jiaola1234-tech/adau1979-fpga/对比分析与处理建议.md

# FPGA 底板与 DSP 大板对比及改造建议

## 依据

- FPGA/底板工程：`2026底板开发板-7.7/后改2025底板电路原理图.SchDoc`、`后改2025底板线路板图.PcbDoc`
- DSP 工程：`DSP大板子/DSP大板子.SchDoc`、`DSP大板子/DSP大板子.PcbDoc`
- 两个目录中未发现 `.v/.sv/.vhd/.xdc/.qsf/.xpr/.sof/.bit` 等 FPGA HDL、管脚约束或比特流文件，以下是硬件级对比。

## 对比表

| 功能块 | 原 FPGA 底板 | DSP 大板 | 结论 / FPGA 侧处理 |
|---|---|---|---|
| ADC 主器件 | U6：1 颗 AD7606 | U3、U10：2 颗 ADAU1979WBCPZ-RL | 不能按引脚替换；从并行 SAR ADC 改成音频串行 ADC，需重做原理图、PCB、RTL 接收链和初始化软件。 |
| 模拟输入通道 | `ADIN1~ADIN8`，8 路 | `AIN1_P/N~AIN8_P/N`，8 路差分；同时保留 `ADIN1~ADIN8` 作为前级接口 | 保留前级 ADIN 命名可以减少改线，但每路要重新核对差分、共模、电平、增益和抗混叠滤波。不能把 AD7606 的模拟输入网络直接接到 ADAU1979。 |
| AD7606 数字接口 | `DB0~DB15`、`CS`、`CONVSTAB`、`BUSY`、`RESET`、`RD` | 无并行数据总线；`MCLK`、`BCLK`、`LRCLK`、`SDATAOUT01/02/11/12`、`SCL/SDA`、`ADC_PD_RST_N` | 删除/隔离 AD7606 的 DB/CS/CONVST/BUSY/RD 逻辑；新增 I2C 主控、音频串行接收器、帧同步和复位时序。 |
| 音频时钟 | Y7：25 MHz；主要是 FPGA/PS 时钟 | OSC1：24.576 MHz；另外有 X1：12 MHz、Y1：25 MHz | 24.576 MHz 是音频时钟，不能由 25 MHz 直接代替。建议在 ADAU1979 附近保留独立低抖动时钟，并在 FPGA 中建立独立 audio clock domain。 |
| ADAU 控制 | 无 ADAU 控制总线 | `SCL/SDA`，两颗 ADAU 共用音频时钟，`ADC_PD_RST_N` 为复位/掉电控制 | 需要确认两颗 ADAU 的 I2C 地址/地址脚；上电后按数据手册写寄存器，再打开数据流。 |
| ADAU 数据通道 | 不存在 | 两颗 ADAU 输出 `SDATAOUT01/02/11/12`，共享 `BCLK/LRCLK/MCLK` | 先确认 DSP 工程配置的是 2-wire/4-wire、左对齐/I2S/TDM、采样率和每帧槽位，再实现 FPGA RX；不要只按信号名连接。 |
| 前级仪表放大 | 8 颗 AD620BR | 同样有 8 颗 AD620BR | 这部分可作为复用基础，但要按 ADAU1979 的满量程和输入共模重新计算 AD620 增益。 |
| 后级模拟处理 | 未发现 LT1793、DG201 | 8 颗 LT1793（U27~U34）+ 8 颗 DG201（U35~U42），另有 `GAIN_X1/X10/X30/X99` | 这是 DSP 相对 FPGA 的主要模拟硬件增量。若功能要求与 DSP 一致，应增加抗混叠/缓冲/增益切换链；`CS0~CS7` 多半是 DG201 控制，不能误当 ADAU 的片选。 |
| 参考/偏置 | FPGA 工程有 `REFIN`、`AVCC`、`VDRIVE` 等 AD7606 相关电源/参考网络 | DSP 有 `VBIAS_1V5`、`VBIAS_1V5_RAW`、U43 REF2030、U44 OPA192、`IOVDD`、`AVDD` | 删除 AD7606 的参考/驱动网络；新增 1.5 V 模拟偏置、3.0 V 参考/缓冲和 ADAU 的 AVDD/IOVDD 去耦，按数据手册分区供电。 |
| FPGA/处理器连接 | 大量 `FPGA_*`、`PS_*`、`IOxx`，含 RGMII `PS_ETH_*` | DSP 侧有 `UP_*`、`VPIF_*`、多路 UART 和扩展连接 | ADAU 数据接入 FPGA 后，需明确由 FPGA 直接处理，还是送到外部 DSP。若 FPGA 直接处理，DSP 侧 VPIF/控制器不必照搬；若保留 DSP，则只需把音频链路接到 DSP 接口。 |
| 以太网 | U100：RTL8211E-VB；`PS_ETH_TXD0~3/RXD0~3`，RGMII 风格 | U12：KSZ8081RNACA-TR；`RMII_*`、`ETH_TXP/M`、`ETH_RXP/M`，含 RJ45/ESD | 不能直接替换。两者 MAC 接口宽度、时钟和 PHY 配置不同；建议保留 FPGA 原 RGMII，以太网部分只移植 DSP 的接口防护/磁性器件需求。 |
| CAN | TJA1057 收发器，FPGA 侧有 `CAN_RX/CAN_TX` | MCP2515（U9）+ TJA1057，`CAN_CS_N/CAN_SCK/CAN_SI/CAN_SO/CAN_INT_N/CAN_RST_N` | DSP 的 MCP2515 是完整 SPI CAN 控制器。若 FPGA 已有 CAN 控制器，不要重复加入 MCP2515；只有在需要复用 DSP 软件/协议且 FPGA 无 CAN 控制器时才增加 SPI 外设。 |
| EEPROM | 未发现 M24C64 | U5：M24C64，I2C | 若需要保存 ADAU 配置、校准系数或板卡参数，新增 EEPROM，并与 ADAU I2C 地址/上拉电阻统一规划。 |
| USB/串口 | U20：CH340C | U1：CH340G | 功能近似；保留 FPGA 原 USB-UART 即可，核对 5 V/3.3 V 电平和 USB ESD。 |
| 电源体系 | 有 24 V、+12 V、±15 V、+5、1.8 V、3.3 V、AD7606 `AVCC/VDRIVE` 等 | 有 `+24V_SYS`、`+5V_SYS`、±12 V、±15 V、`VBIAS_1V5`、`AVDD`、`IOVDD`；TPS54560、URA2412、URA2415、REF2030/OPA192 等 | 先做电源树和电流预算，再决定哪些 DSP 电源级移植。ADAU 的模拟/数字电源、时钟和基准必须单独核对噪声与上电时序。 |
| 扩展连接器 | 2×30、2×20、2×5 等 FPGA/底板连接 | 4 个 `CON50A_0`，另有 2×5、2×7 等 DSP 扩展 | 连接器、针脚数和机械位置不兼容。建议先定义一份“FPGA-ADAU/DSP 信号分配表”，再改 PCB，不要边画板边分配信号。 |
| PCB/布线 | 原板有 AD7606 并行总线、FPGA 高速 IO、RGMII | DSP 板有两颗 ADAU、模拟前端、音频时钟、RMII、CAN、较多模拟电源 | 建议以 FPGA 板为主板重新布局 ADC/时钟/模拟区；不能只替换封装或做局部 ECO。 |

## 推荐处理顺序

1. **先冻结系统架构**：确认 ADAU1979 的两颗器件由 FPGA 直接接收，还是仍由外部 DSP 接收；确认采样率（48/96/192 kHz）、输出格式（I2S/TDM/左对齐）、位宽、通道槽位和是否需要 8 路同时处理。
2. **建立信号分配表**：至少包含 `AINx_P/N`、`MCLK/BCLK/LRCLK`、4 路 `SDATAOUT`、`SCL/SDA`、`ADC_PD_RST_N`、8 路 `GAIN_X* / CS0~CS7`、电源和地。每个信号同时写明 FPGA 管脚、连接器针脚、电平标准、方向和时钟域。
3. **重画模拟链**：以 DSP 板的 AD620 → LT1793 → DG201 → ADAU1979 为参考，把 8 路复制到 FPGA 版本；重新计算 AD620 增益、LT1793 滤波器、DG201 导通电阻/电压范围、ADAU 满量程和 1.5 V 共模。输入端、模拟地和数字地按 ADC 数据手册布局。
4. **重做电源和时钟**：加入 24.576 MHz 音频振荡器、ADAU AVDD/IOVDD、1.5 V 偏置/参考和去耦；为模拟电源、数字电源、时钟电源做电流预算、噪声预算和上电顺序检查。
5. **先实现最小 FPGA RTL**：`i2c_master` → ADAU 初始化寄存器表 → `audio_rx`（MCLK/BCLK/LRCLK/SDATA）→ 8 通道 FIFO/AXI-Stream → 原 DSP 算法接口。先不接 Ethernet/CAN 等附加功能，先验证音频采集链。
6. **再处理外设增量**：按需求选择 EEPROM、MCP2515、KSZ8081/RJ45、USB-UART 和 DSP 连接器。已有 FPGA RGMII/CAN 控制器的功能不要重复移植，只移植真正缺失的硬件。
7. **最后改 PCB**：完成封装库、层叠、阻抗、模拟/数字分区、时钟和音频差分/单端走线后，再进行 DRC、3D、装配和可制造性检查。AD7606 的原并行总线区域不能直接当作 ADAU 布局区域使用。

## FPGA 侧最小 RTL/软件模块

- `adau1979_i2c_init`：两颗器件独立地址、复位延时、寄存器配置、读回校验。
- `audio_clk/reset`：24.576 MHz 时钟输入、BCLK/LRCLK 同步、跨时钟域 FIFO、复位释放顺序。
- `adau1979_rx`：根据实际格式接收 24-bit 样本，做符号扩展、通道重排和帧错误检测。
- `gain_switch_ctrl`：如果保留 DG201，生成 `CS0~CS7` 或对应 `GAIN_X1/X10/X30/X99` 控制，并设置 break-before-make。
- `calibration/eeprom`：可选，用于保存通道增益、偏置和 ADAU 配置。

## 上板前必须验证的项目

- ADAU 两颗 I2C 地址是否冲突；SCL/SDA 上拉电压是否与 FPGA I/O 电平一致。
- 24.576 MHz、BCLK、LRCLK 的频率关系和抖动；FPGA 约束是否覆盖所有 generated clocks。
- 8 路输入的满量程、共模、电源范围、AD620 增益和 LT1793 截止频率。
- `SDATAOUT01/02/11/12` 的通道顺序、帧槽位、MSB/LSB 顺序和 24-bit 对齐。
- ADAU AVDD/IOVDD、1.5 V 偏置和数字电源的上电、掉电、复位时序。
- FPGA 管脚复用是否与原 `PS_ETH_*`、LCD、DDR、JTAG、UART、CAN 等功能冲突。
- 音频链路先用示波器/逻辑分析仪确认时钟和 I2C，再用已知正弦输入验证 8 路幅值、相位、噪声和失真。

## 目前无法从目录直接确定的内容

- FPGA 型号、封装和实际管脚号；
- 现有 AD7606 的 HDL 采集时序和软件寄存器接口；
- ADAU1979 两颗器件的 I2C 地址脚配置；
- 最终采样率/串行音频格式/通道槽位；
- FPGA 板与 DSP 板连接器的针脚一一对应关系。

这些内容需要 FPGA 源工程、ADAU1979 原理图页或数据手册配置表补齐后，才能生成可直接用于约束文件和 PCB 的最终引脚表。

## 隔离、保护和电源器件专项对比

| 类别 | 原 FPGA 底板 | DSP 大板 | 建议 |
|---|---|---|---|
| 信号隔离 | U21：ISO7221AD 数字隔离器；FPGA 板没有 PC817 类光耦 | U2：PC817X2CSP9F 双路光耦；Q1：2N7002 做后级整形/电平转换 | ISO7221AD 不是光耦，不能与 PC817 按器件名称等同。只有移植 DSP 的 24 V 脉冲/外部控制接口时，才新增 PC817 隔离链。 |
| 电源隔离 | U241：URA2424S-6WR3；U242：URA2415S-6WR3 | U25：URA2412S-6WR3；U26：URA2415YMD-15WR3 | 需要按 ADAU、模拟前端和外部接口的实际电压/电流重新核算，不能直接照抄型号。重点确认隔离侧地、耐压、输出纹波和启动时序。 |
| 输入浪涌/电源保护 | F1：24 V 保险丝；D2：SMAJ13CA；D241：BZT52C24；另有 6 个 PESD3V3L1BA | F1：0451003；D1/D8：SMBJ33A；D7：BZT52C12；Q2：DMP6023LE-13；另有 PESD3V3L1BA | FPGA 已有基本保护，但 DSP 的 24 V 输入保护链更完整。迁移时按实际外部电压选择 TVS 的反向工作电压和钳位电流，不要只按封装替换。 |
| CAN 保护 | FPGA 有 TJA1057，但未看到 DSP 的 PESD2CAN | DSP 有 D3：PESD2CAN，配 MCP2515 + TJA1057 | 若保留 CAN，应在 CANH/CANL 连接器侧增加专用 CAN TVS，并配合终端电阻、共模/地回流路径检查。 |
| USB/接口 ESD | FPGA 有多颗 PESD3V3L1BA | DSP 有 D5：TPD4E1U06，另有 PESD3V3L1BA | USB、网口、外部连接器的 ESD 器件要靠近连接器放置，不能只在芯片附近放置。 |
| 网口保护 | FPGA：RTL8211E 方案 | DSP：KSZ8081 + RJ45 + TPD4E1U06/磁珠网络 | 两种 PHY 不同，网口保护和磁性器件按最终 PHY 方案保留，不能直接互换。 |
| 24 V 外部脉冲/控制 | 未见与 DSP 相同的 `PULSE_EXT_24V+` 光耦输入链 | PC817、SMBJ33A、2N7002，带 `PULSE_EXT_24V+`、`PULSE_OUT`、`PULSE_24V_GND` | 如果新 FPGA 系统需要 DSP 的脉冲输入/输出功能，这一整条链需要新增；如果不需要，应从移植清单中排除。 |

判断原则：光耦、数字隔离器、隔离电源和 TVS 都要按接口功能和电压等级判断，不能仅按器件名称一一对应。当前 FPGA 板没有 PC817 光耦；ISO7221AD 只能说明板上存在某一路数字信号隔离，不能替代 24 V 输入端的光耦、限流和浪涌保护。先列出每个外部接口的工作电压、故障电压、隔离耐压、信号方向和速率，再决定是否移植。

## 以 FPGA 板为基础的新增器件清单

下面清单只列“相对现有 FPGA 板需要新增或重新设计”的器件。DSP 板中的所有器件不应整板照搬。

### A. ADAU1979 音频采集必需器件

| 器件 | DSP 工程参考 | 建议数量 | 用途 |
|---|---|---:|---|
| ADAU1979WBCPZ-RL | U3、U10 | 2 | 替换 AD7606，完成 8 路音频 ADC；两颗器件的 I2C 地址和数据输出配置要确认 |
| 24.576 MHz 有源振荡器 | OSC1：OT2EL4C4JI-111OLP-24.576M | 1 | ADAU 音频主时钟 MCLK；需低抖动、靠近 ADAU 放置 |
| 低噪声 3.3 V LDO | LP5907MFX-3.3/NOPB | 1 或按电源域增加 | 给 ADAU 的 AVDD/IOVDD 或时钟/模拟敏感电源供电，具体由电源树确定 |
| 磁珠 | MPZ1608S221ATA00 | 1/每个敏感电源域 | 隔离模拟电源与数字电源噪声 |
| 2.048/3.0 V 参考源 | REF2030AIDDCR，U43 | 1 | 参考/偏置基准；最终电压以 ADAU1979 数据手册和设计方案为准 |
| 精密运放 | OPA192IDBVR，U44 | 1 | 参考缓冲和 1.5 V 偏置缓冲 |
| 1.5 V 偏置网络 | DSP 中 `VBIAS_1V5`、`VBIAS_1V5_RAW` 周边电阻电容 | 1 套 | 给 ADAU 模拟输入提供共模偏置 |
| 去耦/滤波电容、电阻 | U3/U10 周边网络 | 按原理图复制 | 每颗 ADAU 的 AVDD、DVDD、IOVDD、REF、输入端都要单独核对，不建议只按“几个 0.1 uF”估算 |
| I2C 上拉电阻 | `SCL/SDA` | 1 组 | FPGA 与两颗 ADAU 共用 I2C 时，按总线电容和 I/O 电压选择 |
| 复位/掉电控制器件 | `ADC_PD_RST_N` 周边 | 1 套 | FPGA 控制 ADAU 上电、复位和配置时序 |

### B. 8 路模拟前端必需器件

如果 FPGA 板要完整复现 DSP 板的模拟链，建议新增：

| 器件 | DSP 工程参考 | 建议数量 | 用途 |
|---|---|---:|---|
| LT1793 | U27~U34 | 8 | 每路模拟输入的滤波/缓冲级 |
| DG201BDY-T1E3 | U35~U42 | 8 | 每路增益档位或模拟通道切换 |
| 增益选择电阻网络 | `GAIN_X1/X10/X30/X99` 周边 | 8 路 × 4 档 | 对应 1、10、30、99 倍增益；电阻值必须按目标满量程重新计算 |
| 输入/反馈/滤波电容 | LT1793、DG201 周边 | 按 8 路复制 | 决定带宽、抗混叠和稳定性，不能直接用 AD7606 原输入 RC 网络 |
| 模拟连接器和测试点 | `AINx_P/N`、`IOx+/−` | 按通道 | 方便差分输入、示波器测量和生产校准 |

AD620BR 已经在 FPGA 和 DSP 两块板上都有 8 颗左右的对应电路，因此不一定需要新增；但 AD620 的增益电阻和输出共模必须重新按 ADAU1979 输入范围计算。

### C. 需要光耦/隔离的外部接口器件

只有在 FPGA 版本保留 DSP 的外部 24 V 脉冲或控制功能时才加入：

| 器件 | DSP 工程参考 | 建议数量 | 说明 |
|---|---|---:|---|
| 双路光耦 | PC817X2CSP9F，U2 | 1 | 24 V 外部输入与逻辑侧隔离；需要按 CTR、LED 电流和速度设计 |
| N 沟道 MOS | 2N7002，Q1 | 1 或按通道 | 光耦输出后的电平整形/开关 |
| 24 V TVS | SMBJ33A，D1/D8 | 2 或按外部接口 | 24 V 脉冲输入/输出浪涌保护，需根据接口最大电压确认型号 |
| 快恢复/小信号二极管 | 1N4148W，D? | 按保护支路 | 光耦、MOS 栅极或钳位支路保护 |
| 隔离电源 | URA2412S-6WR3、URA2415YMD-15WR3 | 按隔离域 | 给外部接口或模拟域供电；不能因为 DSP 有就无条件照搬 |

当前 FPGA 板没有 PC817 光耦。ISO7221AD 是已有的数字隔离器；如果不移植 DSP 的 24 V 脉冲/外部控制接口，则 PC817、2N7002 及其输入保护链都不需要新增。若确实要移植该接口，PC817 需要与限流电阻、反向保护、TVS、2N7002 和隔离侧电源一起设计。

### D. CAN 功能移植器件

仅当 FPGA 需要使用 DSP 板相同的 MCP2515-SPI CAN 架构时加入：

| 器件 | DSP 工程参考 | 建议数量 | 说明 |
|---|---|---:|---|
| CAN 控制器 | MCP2515T-I/SO，U9 | 1 | FPGA 通过 SPI 控制；若 FPGA 已有 CAN RTL/IP，则不需要 |
| CAN 控制器时钟 | X503216MSB2GI 或等效 16 MHz 器件 | 1 | MCP2515 的时钟源，需按最终型号确认 |
| CAN 专用 TVS | PESD2CAN，D3 | 1 | 放在 CANH/CANL 连接器入口 |
| CAN 收发器 | TJA1057GT3 | 现有可复用 | 核对逻辑电平、待机脚和电源，不要重复放置 |
| 终端/共模器件 | 终端电阻、共模电感、连接器 | 按接口 | 按总线拓扑和是否终端节点决定 |

### E. EEPROM 和配置存储

| 器件 | DSP 工程参考 | 建议数量 | 用途 |
|---|---|---:|---|
| I2C EEPROM | M24C64-RMN6TP，U5 | 1 | 保存 ADAU 寄存器配置、通道校准和板卡参数 |
| EEPROM 上拉/地址电阻 | U5 周边 | 1 套 | 与 ADAU 的 I2C 地址规划一起设计，避免地址冲突 |

### F. 网口、USB 和电源保护的可选新增器件

| 功能 | 可选新增器件 | 何时需要 |
|---|---|---|
| RMII 网口 | KSZ8081RNACA-TR、RJ45 SI-46001-F、25 MHz 晶振、磁珠 | 只有准备把 FPGA 原 RTL8211E/RGMII 改成 DSP 的 RMII 方案时才需要；通常建议保留 FPGA 原 RGMII |
| 网口/USB ESD | TPD4E1U06、PESD3V3L1BA | 外部 USB、网口或高速连接器需要额外 ESD 防护时 |
| 24 V 入口保护 | 0451003 保险丝、SMBJ33A、DMP6023LE-13、BZT52C12 | 需要把 DSP 的反接、过压和浪涌保护链移植到 FPGA 板时 |
| 低噪声模拟电源 | LP5907、磁珠、局部 LDO、去耦电容 | ADAU 模拟电源噪声不满足指标，或现有 3.3 V 电源不能直接使用时 |

### 最小采购优先级

如果目标只是“把 AD7606 换成 ADAU1979，并让 FPGA 先采到音频”，第一批至少准备：

1. 2 颗 ADAU1979WBCPZ-RL；
2. 1 个 24.576 MHz 振荡器；
3. ADAU 专用 3.3 V 低噪声供电、磁珠、去耦电容；
4. REF2030 + OPA192 + 1.5 V 偏置网络；
5. I2C 上拉、复位/掉电控制和配置电阻；
6. 按 8 路模拟链新增 LT1793、DG201 及其电阻电容；
7. ADAU、时钟、电源和模拟输入连接器/测试点。

PC817、MCP2515、M24C64、KSZ8081、RJ45、TPD4E1U06 和 DSP 的 24 V 保护链属于功能扩展件，不能在没有确认需求时全部加入。

## 尽量不改 FPGA 主板的实施方案

如果目标是保留已经完成的 FPGA PCB，推荐采用“ADAU1979 音频子板 + 现有 FPGA 主板”的方案，不要把 ADAU1979 直接塞进 AD7606 的原封装位置。ADAU1979 与 AD7606 封装、供电、参考、时钟和数字接口都不同，直接改 U6 周围走线的风险最高。

### 主板尽量保持不变

以下部分先不动：

- FPGA 芯片、DDR、配置电路、JTAG、USB-UART；
- 原有以太网 RTL8211E/RGMII；
- 原有 TJA1057、ISO7221AD、隔离电源、保险丝和基础 TVS；
- 原有 24 V、±15 V、5 V、3.3 V 电源，只检查是否有足够余量；
- 原有 2×30、2×20、2×5 等 FPGA 扩展连接器。

如果 AD7606 位于独立的“24 位 AD 小板”，最简单的做法是只重新制作这块 AD 小板，FPGA 主板和原连接器都不改。如果 AD7606 已经焊在 FPGA 主板上，则保留 PCB，不再安装 U6，必要时只切断少量与 `DB0~DB15/CS/RD/BUSY/CONVSTAB` 冲突的铜箔，再用 0 Ω 电阻或飞线把串行音频信号接到空闲 FPGA IO。

### 只新增一块 ADAU1979 子板

子板建议放置：

| 子板器件 | 数量 | 作用 |
|---|---:|---|
| ADAU1979WBCPZ-RL | 2 | 两颗合计 8 路 ADC，匹配原 AD7606 的 8 路输入数量 |
| 24.576 MHz 振荡器 | 1 | 在子板本地产生 ADAU 音频主时钟；不要求 FPGA 主板提供 24.576 MHz |
| 3.3 V 低噪声 LDO | 1 | 给 ADAU 模拟/数字电源提供干净电源；输入可取主板 5 V 或 3.3 V，需核算电流 |
| 磁珠和去耦电容 | 1 套 | 分开 AVDD、IOVDD、数字电源和时钟电源 |
| REF2030 + OPA192 | 各 1 | 生成/缓冲 ADAU 输入需要的参考或 1.5 V 偏置 |
| I2C 上拉、地址电阻、复位电阻 | 1 套 | 两颗 ADAU 共用 I2C，地址必须不同 |
| 输入 RC/抗混叠网络 | 8 路 | 把现有 AD620 输出适配到 ADAU 输入；具体值需按采样率和满量程确定 |
| 子板连接器 | 1 组 | 输出 `SDATAOUT01/02/11/12`、`BCLK`、`LRCLK`、`SCL`、`SDA`、`ADC_PD_RST_N` 和电源地 |

这里的“两颗 ADAU1979”是因为 DSP 原理图使用两颗器件来覆盖 8 路输入；如果你的实际需求少于 8 路，可以再减少器件数量，但要重新规划通道和接口。

### 不要为了凑齐 DSP 器件而增加的部分

在最小改板方案中，下列器件暂时不增加：

- 8 颗 LT1793 和 8 颗 DG201：只有在确实需要 DSP 的四档模拟增益或额外滤波时才加入；优先复用 FPGA 板已有 AD620 和输入调理电路；
- PC817、2N7002、SMBJ33A：只有需要 DSP 的 24 V 脉冲输入/输出时才加入；
- MCP2515、16 MHz 时钟、PESD2CAN：只有 FPGA 没有 CAN 控制器且必须复用 MCP2515-SPI 方案时才加入；
- KSZ8081、RJ45、25 MHz 网口晶振：不加入，继续使用 FPGA 原 RTL8211E/RGMII；
- M24C64：不是音频采集必需件；第一版可由 FPGA 上电后通过 I2C 写 ADAU 配置；
- DSP 的 URA2412、URA2415、TPS54560 等电源模块：先复用 FPGA 现有电源，只有电流、噪声或隔离要求不满足时再增补；
- CH340G、USB ESD：FPGA 已有 CH340C，不能重复增加。

### FPGA 只需要改的逻辑

主板不重画的前提下，FPGA 工程仍需做这些 RTL/约束修改：

1. 保留原 AD7606 模块作为备份，但停止使用 `DB0~DB15`、`RD`、`BUSY`、`CONVSTAB` 采集路径。
2. 新增 I2C 主控，给两颗 ADAU1979 写初始化寄存器；如果配置表固定，可直接固化在 FPGA ROM 中。
3. 新增 4 路音频串行接收：`SDATAOUT01/02/11/12`，接收 `BCLK/LRCLK` 下的 24 位数据。
4. 用子板产生的 `BCLK/LRCLK` 建立音频时钟域，再通过异步 FIFO 送入原 FPGA 处理时钟域。
5. 重新添加 I/O 约束，只约束子板实际接出的 FPGA IO；不要把原 AD7606 的并行管脚继续配置成输入。

### 最小主板 ECO 清单

- 确认现有连接器上至少有 4 个空闲 FPGA IO、1 个 I2C 输出组、1 个复位输出和足够的 3.3 V/GND；
- 若没有空闲 IO，优先使用原 AD7606 并行数据线中的 4 根或更多根作为串行音频线，其他线保持不接；
- 在主板上只增加连接器、0 Ω 电阻、必要的串联阻尼电阻和飞线测试点；
- 不在主板上重新布 ADAU 的模拟输入、24.576 MHz 时钟和敏感电源，这些都放在子板上；
- 第一版先不迁移 DSP 的光耦、CAN、网口和复杂电源，等音频链路验证后再按功能逐项加入。

这个方案的代价是需要重新设计一块 ADAU1979 子板，并修改 FPGA HDL；但可以避免重画 FPGA 主板，也避免在原 AD7606 区域进行大规模模拟和高速布线改动。

## 已实际加入目标工程（2026-10-28）

目标工程 `adau1979-fpga/adau1979-fpga.PrjPcb` 已登记 10 个项目文档，文件位于 `adau1979-fpga/Libraries/`：

- `ADAU1979_Core.SchLib` / `ADAU1979_Core.PcbLib`
- `OPA192.SchLib` / `OPA192.PcbLib`
- `REF2030.SchLib` / `REF2030.PcbLib`
- `FerriteBead.SchLib` / `FerriteBead.PcbLib`
- `FPGA_Baseboard.SchLib` / `FPGA_Baseboard.PcbLib`

没有加入光耦库；原 FPGA 板的 `ISO7221AD` 仍按数字隔离器处理。打开目标工程后即可在 Components/Libraries 中检索 `adau1979wbcpz-rl`。
