jiaola1234-tech/adau1979-fpga/DSP大板子/PCB_Project/PCB_Project.pdf

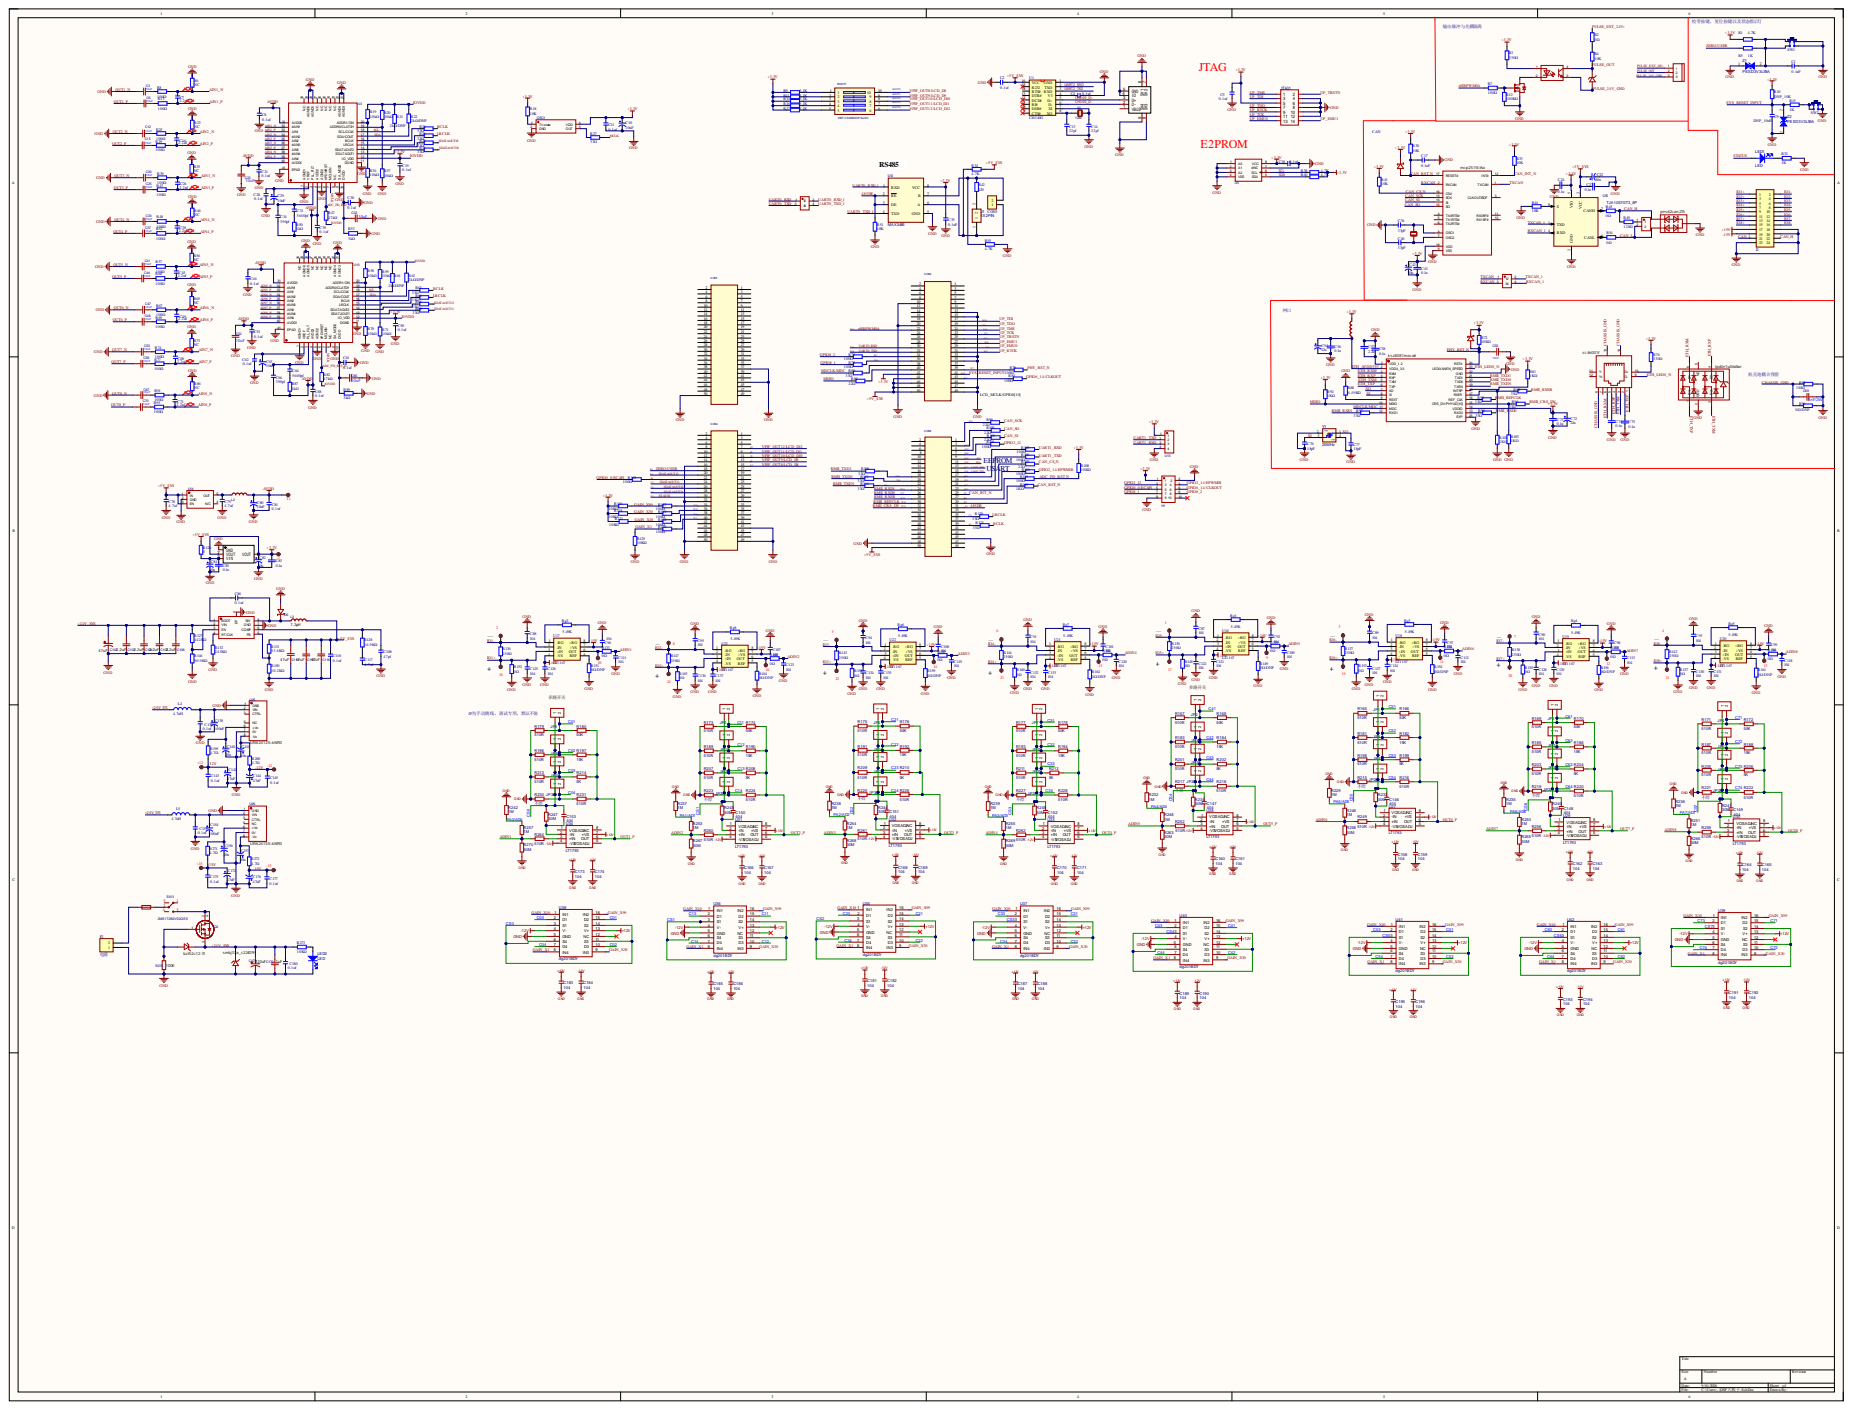
[picture p1: page 1]

AGND3 21 AGND4 22 NC 23 NC 24 NC 25 NC 26 NC 27 AGND5 28 AGND6 29 NC 30

DVDD 10 DGND 11 IO_VDD 12 SDATAOUT1 13 SDATAOUT2 14 LRCLK 15 BCLK 16 SDA/COUT 17 SCL/CCLK 18 ADDR0/CLATCH 19 ADDR1/CIN 20

5BIT 2.54MM DIP Switch | | BOOT1 | CON_5PIN_DIP_2D5 4 | 5BIT DIP SOP Switch | 1

0.1uF 0.1uf | 贴片电容 无极性贴片电容, 贴 片电容 | C2, C4, C5, C8, C11, C1 C17, C18, C19, C21, C28, C30, C35, C39, C46, C50, C51, C61, C62, C68, C81, C86, C110, C139, C143, C145, C155, C175, C177, C180 | C 0805_L 0603C | C C | 1 29

10uF | 容值:10uF;精度:± 10%;额定电压:100V; 温度系数:X7R; | C3, C6, C12, C15, C20, C25, C33, C37, C41, C44, C47, C48, C53, C55, C59, C67, C70 | C1210 | fs32x106k101egg | 17

DNP_10nF 2.2nf 22pf 10uF 10u | 无极性贴片电容 无极性贴片电容 无极性贴片电容 [NoValue], 10µF/25V | C9 C7, C16, C26, C38, C45, C49, C60, C71 C13, C14 C10, C29, C63, C80 C22, C42, C82, C84, C140, C141, C156, C157 | 0603C 0603C 0603C 5x11mm 5x11mm | C C C CAP_2 CAP | 1 8 2 4 8

10uF | 容值:10uF;精度:± 10%;额定电压:25V;温 度系数:X7R; | C23, C32, C52, C65 | C1206 | cl31b106kahnnne | 4

0.1u | Capacitor | C24, C27, C43, C56, C58, C73, C74, C75, C83, C85 | 0603C | Cap | 10

5600pf 33pF 390pf 2.2u 22u 1nF/2kV | 无极性贴片电容 贴片电容 无极性贴片电容 容值:10uF;精度:± Capacitor 10%;额定电压:25V;温 度系数:X7R; | C31, C64 C36, C40 C34, C66 C57 C54, C72 C69 | 0603C 0603C 0603C 0603C 5x11mm C1206 | C C C Cap CAP cl31b106kahnnne | 2 2 2 1 2 1

4.7uf 18pF 104 | 无极性贴片电容 贴片电容 贴片电容 | C87, C88, C89, C90, C78, C79 C76, C77 C91, C92, C93, C94, C95, C96, C97, C98, C99, C100, C101, C107, C109, C111, C112, C113, C118, C119, C120, C121, C122, C123, C124, C125, C126, C127, C128, C129, C130, C131, C132, C133, C134, C135, C136, C137 | 0603C 0603C 0603C | C C C | 2 2 40

47uF | 容值:47uF;精度:± 20%;额定电压:63V;纹 波电 流:405mA@100kHz; 等效串联电阻 (ESR):342mΩ @100kHz;, 47µF/25V | C102, C142, C144, C172, C176 | CAP-TH_BD8.0-P3.50-D0.6-FD | rxw470m1jbk-0811p, CAP | 5

2.2uF | 容值:2.2uF;精度:± 10%;额定电压:100V; 温度系数:X7R; | C103, C104, C105, C106 | C1210 | fs32x225k101egg | 4

47pf 47uF | 容值:2.2uF;精度:± 无极性贴片电容 10%;额定电压:100V; 温度系数:X7R; | C108 C114, C115, C116 | 0603C C1210 | C fs32x225k101egg | 1 3

100uF 4.7nf 404 | 100µF/63V 无极性贴片电容 贴片电容 | C138, C154 C117 C146, C147, C148, C149, C150, C151, C152, C153 | CAP-TH_BD8.0-P3.50-D0.6-FD 0603C C 0603_L | CAP C C | 2 1 8

104 | 贴片电容 | C158, C159, C160, C161, C162, C163, C164, C165, C166, C167, C168, C169, C170, C171, C173, C174, C181, C182, C183, C184, C185, C186, C187, C188, C189, C190, C191, C192, C193, C194, C195, C196 | C 0603_L | C | 32

220uF | 容值:220uF;精度:± 20%;额定电压:63V;纹 波电 流:1.5A@100kHz;等 效串联电阻 (ESR):33mΩ @100kHz; | C178 | CAP-TH_BD10.0-P5.00-D1.0-FD | eeufr1j221l | 1

1uF | 容值:1uF;精度:±10%; 额定电压:50V;温度系 数:X7R; | C179 | C0805 | grm21br71h105ka12 l | 1

HDR-1X2 smbj33a_c224019 | 2P接插件 极性:单向;反向截止 电压(Vrwm):33V;钳位 电压:53.3V;峰值脉冲 电流 (Ipp):11.3A@10/100 0us;峰值脉冲功率 (Ppp):600W@10/100 0us;击穿电压:40.6V; | CON5 CON1, CON2, CON3, CON4 D1, D8 | KF128-5.08-2P NLWBS05-50C-2.2H SMB_L4.6-W3.6-LS5.3-RD | Header 2 CON50A_0 smbj33a_c224019 | 1 4 2

1n4148w_c7420318 | 二极管配置:独立式; 整流电流:150mA;直 流反向耐压(Vr):100V; 正向压降 (Vf):1.25V@150mA; 反向恢复时间 (Trr):4ns; | D2, D4 | SOD-123_L2.7-W1.6-LS3.7-FD | 1n4148w_c7420318 | 2

pesd2can,215 | 极性:双向;反向截止 电压(Vrwm):24V;钳位 电压:41V;峰值脉冲电 流(Ipp):5A@8/20us; 峰值脉冲功率 (Ppp):230W@8/20us ;击穿电压:28V; | D3 | SOT-23-3_L2.9-W1.3-P1.90-LS2.4-BR | pesd2can,215 | 1

tpd4e1u06dbvr | 极性:单向;反向截止 电压(Vrwm):5.5V;钳 位电压:15V;峰值脉冲 电流 (Ipp):3A@8/20us;峰 值脉冲功率 (Ppp):45W@8/20us; 击穿电压:8.5V; | D5 | SOT-23-6_L2.9-W1.6-P0.95-LS2.8-BR | tpd4e1u06dbvr | 1

b560c-13-f | 二极管配置:1个独立 式;正向压降 (Vf):700mV@5A;直流 反向耐压(Vr):60V;整 流电流:5A; | D6 | SMC_L7.1-W6.2-LS8.1-RD | b560c-13-f | 1

bzt52c12-7-f | 二极管配置:1个独立 式;稳压值(标称 值):12V;稳压值(范围 值):11.4V~12.7V;耗 散功率(Pd):370mW; | D7 | SOD-123_L2.7-W1.6-LS3.7-RD | bzt52c12-7-f | 1

0451003.mrl | 类型:贴片式保险丝; 额定电流:3A;额定电 压:125V;分断能 力:50A; | F1 | FUSE-SMD_L6.1-W2.7 | 0451003.mrl | 1

a254up-zs05p | 插针结构:2x5P;间 距:2.54mm;行 距:2.54mm;圆针/方 针:方针;安装方式:直 插;排数:双排;总PIN 位数:10P;额定电 流:3A;配合针长 度:6mm;塑 高:2.5mm;触头材质: 铜合金;触头镀层:金; 工作温度:-40℃ ~+105℃;颜色:黑色; | H1 | HDR-TH_10P-P2.54-V-M-R2-C5-S2.54 | a254up-zs05p | 1

Header 2X12 1X2PIN HDR-1X2 | 12*2P接插件 2P接插件 | J2 J1 JP1, JP2, JP3, JP4, JP5, JP6, JP7, JP8, JP9, JP10, JP11, JP12, JP13, JP14, JP15, JP16, JP17, JP18, JP19, JP20, JP21, JP22, JP23, JP24, JP25, JP26, JP27, JP28, JP29, JP30, JP31, JP32 | IDC2.54-LI-2x12P HDR2.54-Y-LI-2P HDR2.54-Y-LI-2P | Header 12X2 1X2PIN Header 2 | 1 1 32

blm18kg601sn1d | 阻抗@频率:600Ω @100MHz;误差:± 25%;直流电阻 (DCR):150mΩ; | JTAG1 L1 | IDC-TH_14P-P2.54-V-R2-C7-S2.54 L0603 | 2.54-2*7P简牛 blm18kg601sn1d | 1 1

mpz1608s221ata00 | 标称阻抗@测试频 率:220Ω@100MHz; 误差:±25%;直流电阻 (RDC):50mΩ; | L2 | L0603 | mpz1608s221ata00 | 1

7.2µH | 电感值:7.2uH;精度:± 30%;额定电流:7.9A; 饱和电流(Isat):6A;类 型:-; | L3 | IND-SMD_L10.2-W10.2_7447798720 | 7447798720 | 1

4.7uH LED ot2el4c4ji-111olp-24.576m | Inductor 频率:24.576MHz;常 温频差:±10ppm;输 出模式:CMOS;工作 电压:1.8V~3.3V;频率 稳定度:±20ppm; | L4, L5 LED1, LED2 OSC1 | 1210L LED 0805R OSC-SMD_4P-L3.2-W2.5-BL | Inductor LED ot2el4c4ji-111olp-24.576m | 2 2 1

wj500v-5.08-03p-14-00a | 结构:1x3P;间 距:5.08mm;颜色:绿 色;安装类型:直插;排 数:1;每排PIN数:3;额 定电流:18A;额定电 压:250V;线规 -AWG:14~30;线规 -平方毫米:2.5;工作温 度:-40℃~+105℃; | P1 | CONN-TH_3P-P5.00_WJ500V-5.08-3P | wj500v-5.08-03p-14-00a | 1

电源 2n7002,215 | 数量:1个N沟道;漏源 Header, 2-Pin 电压(Vdss):60V;连续 漏极电流(Id):300mA; 导通电阻(RDS(on)):5 Ω@10V;耗散功率 (Pd):830mW;阈值电 压(Vgs(th)):2.5V; | P2 Q1 | CONN-TH_2P-P5.08 SOT-23_L2.9-W1.3-P1.90-LS2.4-BR | Header 2 2n7002,215 | 1 1

dmp6023le-13 | 数量:1个P沟道;漏源 电压(Vdss):60V;连续 漏极电流(Id):7A;导通 电阻(RDS(on)):35mΩ @4.5V;耗散功率 (Pd):2W;阈值电压 (Vgs(th)):3V; | Q2 | SOT-223-4_L6.5-W3.5-P2.30-LS7.0-BR | dmp6023le-13 | 1

4.7K 10K 330Ω 0Ω NC 1K | 贴片电阻 贴片电阻 贴片电阻 | R1, R34, R55 R4, R18 R3 R2 R6, R23, R35, R46, R56, R65, R73, R86 R5, R15, R32 | 0603R 0603R | R R, R_10 R R R R | 3 2 1 1 8 3

100Ω | 贴片电阻 | R7, R8, R13, R25, R29, R39, R43, R48, R52, R57, R60, R67, R69, R74, R77, R91, R95 | 0603R | R | 17

5.1K 100KΩ DNP_10K 2kΩ/DNP 10kΩ 33Ω | 贴片电阻 贴片电阻 贴片电阻 | R9, R11, R14, R16, R17 R12 R10 R21, R22, R61, R62 R19, R20, R36, R37, R58, R59, R70, R71 R24, R26, R27, R28, R31, R63, R64, R66, R68, R120, R123 | 0603R 0603R 0603R 0603R 0603R | R R R R R R_10 | 5 1 1 4 8 11

10K | 贴片电阻 | R30, R33, R41, R44, R51 | | R | 5

120 4.7K 0Ω | 贴片电阻 贴片电阻 贴片电阻 | R42 R38, R40 R45, R54, R129, R133, R134, R135, R139, R140, R141, R145, R148, R152, R153, R155, R157, R158, R160, R163 | 0603R | R R R | 1 2 18

47kΩ 3kΩ 1kΩ 120Ω 10KΩ | 贴片电阻 贴片电阻 贴片电阻 贴片电阻 贴片电阻 | R47, R82 R53, R89 R50, R87 R49 R72, R108, R116, R118, R121, R125, R273 | 0603R 0603R 0603R | R R R R R | 2 2 2 1 7

100Ω | 贴片电阻 | R75, R78, R79, R83, R104, R105, R106, R110, R112, R113, R117, R119, R122, R124 | R | 14

330Ω 33Ω | 贴片电阻 | R76 R80, R90, R93, R94, R97, R98, R109, R111, R114 | R R | 1 9

1KΩ | 贴片电阻 | R81, R92, R102, R103, R115 | R | 5

1MΩ 22Ω 6.49KΩ 0Ω/DNP | 贴片电阻 贴片电阻 贴片电阻1% 贴片电阻 | R85 R84, R99, R100, R101, R107 R96, R149, R151, R88 R154, R156, R159, R161, R162, R164 | R R | 1 5 1 9

0 16.9KΩ 442KΩ 250Ω | 贴片电阻 贴片电阻 | R126 R128 R127 R130, R136, R137, R138, R142, R143, R144, R147 | 0603R | R R | 1 1 1 8

243KΩ 53.6KΩ 10.2KΩ 90.9KΩ 510R | 贴片电阻 贴片电阻 贴片电阻 贴片电阻 贴片电阻 | R132 R131 R150 R146 R165, R167, R169, R171, R173, R175, R177, R179, R181, R183, R185, R187, R189, R191, R193, R196, R198, R201, R203, R205, R207, R209, R211, R213, R216, R218, R220, R222, R224, R226, R228, R231, R249, R252, R256, R259, R260, R261, R262, R264 | R R R R R | 1 1 1 1 40

50K | 贴片电阻 | R166, R168, R170, R172, R174, R176, R178, R180 | R | 8

15K | 贴片电阻 | R182, R184, R186, R188, R190, R192, R194, R197 | R | 8

4.7Ω 5K | 贴片电阻 | R195, R200, R271, R272 R199, R202, R204, R206, R208, R210, R212, R214 | R R | 4 8

不焊 | 贴片电阻 | R215, R217, R219, R221, R223, R225, R227, R230 | | R | 8

1M | 贴片电阻 | R229, R232, R235, R236, R237, R238, R239, R242, R246, R248, R250, R251, R253, R254, R255, R257 | | R | 16

30M | 贴片电阻 | R233, R234, R240, R241, R243, R244, R245, R247, R258, R263, R265, R266, R267, R268, R269, R270 | | R | 16

100K | 电阻类型:厚膜电阻; 阻值:100kΩ;精度:± 1%;功率:125mW;工作 电压:150V;温度系数: ±100ppm/℃; | R274 | R0805_NEW | rc0805fr-07100kl | 1

5.49K si-46001-f | 贴片电阻 连接器类型:RJ45插 座;安装方式:弯插;端 口数量:2;LED:带LED; 屏蔽:有屏蔽;触头镀 层:金;工作温度:0℃ ~+70℃; | Rg1, Rg2, Rg3, Rg4, Rg5, Rg6, Rg7, Rg8 RJ1 | 0603R RJ45-TH_BELFUSE_SI-46001-F | R si-46001-f | 8 1

SW_PB_ESW 2MS1T2B2VS2QES | SW2 | SW1, SW2 SW3 | TSW SMD-6*6*4.3 SW-TH_2MS1T2B2VS2QE S | TSW SMD-6x6 2MS1T2B2VS2QES | 2 1

CH340G pc817x2csp9f | 输入类型:DC;正向压 USB2UART 降(Vf):1.2V;输出电 流:50mA;隔离电压 (Vrms):5kV;直流反向 耐压(Vr):6V;负载电 压:80V;输出通道数:-; 集射极饱和电压 (VCE(sat)):200mV@2 0mA,1mA; | U1 U2 | SOP16M SMD-4_L4.6-W6.5-P2.54-LS10.2-TL | CH340G pc817x2csp9f | 1 1

adau1979wbcpz-rl | 分辨率:24;工作电 压:3.3V~3.6V;接口类 型:I2C；SPI; | U3, U10 | QFN-40_L6.0-W6.0-P0.50-TL-EP4.1 | adau1979wbcpz-rl | 2

MAX3485 m24c64-rmn6tp | 接口类型:I2C;存储容 量:64Kbit;时钟频率 (fc):1MHz; | U4 U5 | SOIC-8 SOIC-8_L5.0-W4.0-P1.27-LS6.0-BL | TJA1057GT3 m24c64-rmn6tp | 1 1

TJA1057GT3_8P gpha201-0202a001a1ba | 插针结构:2x2P;间 距:2.54mm;行 距:2.54mm;圆针/方 针:方针;安装方式:直 插;排数:双排;总PIN 位数:4P;额定电 流:3A;塑高:2.54mm; 触头材质:黄铜;触头 镀层:金;工作温度:-40℃~+105℃;颜色: 黑色; | U6 U7, U11 | SOIC-8 HDR-TH_4P-P2.54-V-M-R2-C2-S2.54 | TJA1057GT3_8P gpha201-0202a001a1ba | 1 2

hx pz2.54-1x2p zz | 插针结构:1x2P;间 距:2.54mm;行距:-;圆 针/方针:方针;安装方 式:直插;排数:单排;总 PIN位数:2P;额定电 流:3A;额定电压:1kV; 配合针长度:6mm;塑 高:2.5mm;端接针长 度:3mm;触头材质:黄 铜;触头镀层:金;工作 温度:-40℃~+105℃; 颜色:黑色; | U8 | HDR-TH_2P-P2.54-V-M-3 | hx pz2.54-1x2p zz | 1

mcp2515t-i/so | MCP2515是一款独 立的CAN控制器，支 持CAN V2.0B协议， 数据传输速率为1 Mbps。它通过SPI接 口与MCU通信。 | U9 | SOIC-18_L11.6-W7.5-P1.27-LS10.3-BL | mcp2515t-i/so | 1

ksz8081rnaca-tr | 类型:PHY收发器;端 口数量:1;MAC接 口:RMII; | U12 | QFN-24_L4.0-W4.0-P0.50-BL-EP2.6 | ksz8081rnaca-tr | 1

gpha101-0402a001a1ba | 插针结构:1x4P;间 距:2.54mm;行 距:2.54mm;圆针/方 针:方针;安装方式:直 插;排数:单排;总PIN 位数:4P;额定电 流:3A;塑高:2.54mm; 触头材质:黄铜;触头 镀层:金;工作温度:-40℃~+105℃;颜色: 黑色; | U13 | HDR-TH_4P-P2.54-V-M | gpha101-0402a001a1ba | 1

lp5907mfx-3.3/nopb | 输出极性:正极;工作 电压:5.5V;输出电 压:3.3V;输出电 流:250mA;电源纹波 抑制比 (PSRR):82dB@(1kHz); 输出类型:固定; | U14 | SOT-23-5_L3.0-W1.7-P0.95-LS2.8-BR | lp5907mfx-3.3/nopb | 1

AMS1117-3.3_C6186 | | U15 | SOT-223-3_L6.5-W3.4-P2.30-LS7.0-BR | AMS1117-3.3_C6186 | 1

LT1167 tps54560bddar | CI-AD620BR 功能类型:降压型;工 作电压:4.5V~60V;输 出电 压:800mV~58.8V;输 出电流:5A;输出类型: 可调; | U16, U17, U18, U19, U20, U21, U22, U23 U24 | SO-8 POWERPAD-SO-8_L4.9-W3.9-P1.27-LS6.0-BL-EP | AD620BR tps54560bddar | 8 1

URA2412S-6WR3 | 特性：超宽4:1输入 电压范围。 高效率 达85%。 空载功耗低 至0.24W。 I/O隔离 测试电压1.5kV DC。 输入欠压保护，输出 短路、过流保护。 工作环境温度范围： -40℃至+85℃。应 用：医疗保健。 工 业控制 | U25 | PWRM-TH_URAXXXXS-6WR3 | ura2412s-6wr3_c2757452 | 1

URA2415S-6WR3 | | U26 | PWRM-TH_7P-L22.0-W9.5-P2.54-WRE1205S-3WR2 | ura2415s-6wr3_c5357415 | 1

LT1793 dg201BDY | LT1793CS8#PBF | U27, U28, U29, U30, U31, U32, U33, U34 U35, U36, U37, U38, U39, U40, U41, U42 | SOP-8 dg201BDY | LT1793 DG201BDY-T1E3 | 8 8

12M MicroXNJ x503216msb2gi | 晶振类型:贴片晶振; 频率:16MHz;常温频 差:±10ppm;负载电 容:20pF;频率稳定度: ±20ppm; | X1 USB1 X2 | HC-49S_L11.4-W4.8 MICRO-USB-SMD_MICROXNJ - duplicate OSC-SMD_L5.0-W3.2 | MicroXNJ 12MHz x503216msb2gi | 1 1 1

25MHz PESD3V3L1BA | Y1 Z1, Z2 | SMD3225-4P SOD-323 | CRYSTAL_4P DIODE BI-DIR TRIG | 1 2
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
