jiaola1234-tech/adau1979-fpga/(list of files, drawings)

Other design files:
2026底板开发板-7.7/后改2025底板电路原理图.SchDoc
2026底板开发板-7.7/后改2025底板线路板图.PcbDoc
2026底板开发板-7.7/底板开发板_Project.PrjPcb
adau1979-fpga/adau1979-fpga.PcbDoc
adau1979-fpga/adau1979-fpga.PrjPcb
adau1979-fpga/adau1979_fpga.SchDoc
DSP大板子/DSP大板子.PcbDoc
DSP大板子/DSP大板子.SchDoc
DSP大板子/PCB_Project/PCB_Project.PrjPcb
DSP大板子/器件PCB/1.5V基准源跟随器_OPA192IDBVR.PcbLib
DSP大板子/器件PCB/1×4P插针.PcbLib
DSP大板子/器件PCB/2.2µF_100V、X7R、1210.PcbLib
DSP大板子/器件PCB/2×2P跳线插针.PcbLib
DSP大板子/器件PCB/2×5P插针.PcbLib
DSP大板子/器件PCB/4.7µF_50V、X7R、1206_CL31B475KBHNNNE.PcbLib
DSP大板子/器件PCB/4.7µH电感_SRN6045TA-4R7M.PcbLib
DSP大板子/器件PCB/5V电源功率电感_Würth 7447798720.PcbLib
DSP大板子/器件PCB/5V电源肖特基二极管_B560C-13-F.PcbLib
DSP大板子/器件PCB/10µF、100V、±20%、105℃_100YXJ10M6.3X11.PcbLib
DSP大板子/器件PCB/15V电源输出隔离磁珠_BLM31PG121SN1L.PcbLib
DSP大板子/器件PCB/16MHz晶振.PcbLib
DSP大板子/器件PCB/24V转5V芯片_TPS54560BDDAR.PcbLib
DSP大板子/器件PCB/24V转12V芯片_URA2412S-6WR3.PcbLib
DSP大板子/器件PCB/24V转15V电源模块_MORNSUN URA2415YMD-15WR3.PcbLib
DSP大板子/器件PCB/24V转15V芯片_URA2415S-6WR3.PcbLib
DSP大板子/器件PCB/24位ad小板子.PcbLib
DSP大板子/器件PCB/47µF_63V、低ESR铝电解_插件,D8xL11.5mm.PcbLib
DSP大板子/器件PCB/100K_0805_Yageo RC0805FR-07100KL.PcbLib
DSP大板子/器件PCB/100µF_50V，低阻、105℃、直插_EEUFR1H101.PcbLib
DSP大板子/器件PCB/C0805_Murata GRM21BR71H105KA12L.PcbLib
DSP大板子/器件PCB/CAN专用TVS.PcbLib
DSP大板子/器件PCB/DSP扩展板.PcbLib
DSP大板子/器件PCB/EEPROM.PcbLib
DSP大板子/器件PCB/MCP2515.PcbLib
DSP大板子/器件PCB/MOS栅极保护稳压管_BZT52C12-7-F.PcbLib
DSP大板子/器件PCB/MOS管（2N7002,215）.PcbLib
DSP大板子/器件PCB/P沟道防反MOS管_DMP6023LE-13.PcbLib
DSP大板子/器件PCB/TVS(有极性).PcbLib
DSP大板子/器件PCB/TVS（无极性）.PcbLib
DSP大板子/器件PCB/三接口压线端子.PcbLib
DSP大板子/器件PCB/两接口压线端子.PcbLib
DSP大板子/器件PCB/保险丝_Littelfuse 0451003.MRL.PcbLib
DSP大板子/器件PCB/光耦.PcbLib
DSP大板子/器件PCB/后改2025底板线路板图.PcbLib
DSP大板子/器件PCB/基准电压芯片_REF2030AIDDCR.PcbLib
DSP大板子/器件PCB/放电二极管.PcbLib
DSP大板子/器件PCB/电容220µF_Panasonic EEU-FR1J221.PcbLib
DSP大板子/器件PCB/磁珠L0603.PcbLib
DSP大板子/器件PCB/网口RJ45 Bel SI-46001-F.PcbLib
DSP大板子/器件PCB/网口芯片KSZ8081RNA.PcbLib
DSP大板子/器件PCB/调理电路板.PcbLib
DSP大板子/器件PCB/跳线排针1×2.PcbLib
DSP大板子/器件PCB/静电和浪涌保护_TPD4E1U06.PcbLib
DSP大板子/器件原理图/1.5V基准源跟随器_OPA192IDBVR.SCHLIB
DSP大板子/器件原理图/1×4P插针.SCHLIB
DSP大板子/器件原理图/2.2µF_100V、X7R、1210.SCHLIB
DSP大板子/器件原理图/2×2P跳线插针.SCHLIB
DSP大板子/器件原理图/2×5P插针.SCHLIB
DSP大板子/器件原理图/4.7µF_50V、X7R、1206_CL31B475KBHNNNE.SCHLIB
DSP大板子/器件原理图/4.7µH电感_SRN6045TA-4R7M.SCHLIB
DSP大板子/器件原理图/5V电源功率电感_Würth 7447798720.SCHLIB
DSP大板子/器件原理图/5V电源肖特基二极管_B560C-13-F.SCHLIB
DSP大板子/器件原理图/10µF、100V、±20%、105℃_100YXJ10M6.3X11.SCHLIB
DSP大板子/器件原理图/15V电源输出隔离磁珠_BLM31PG121SN1L.SCHLIB
DSP大板子/器件原理图/16MHz晶振.SCHLIB
DSP大板子/器件原理图/24V转5V芯片_TPS54560BDDAR.SCHLIB
DSP大板子/器件原理图/24V转12V芯片_URA2412S-6WR3.SCHLIB
DSP大板子/器件原理图/24V转15V电源模块_MORNSUN URA2415YMD-15WR3.SCHLIB
DSP大板子/器件原理图/24V转15V芯片_URA2415S-6WR3.SCHLIB
DSP大板子/器件原理图/24位AD小板子.SCHLIB
DSP大板子/器件原理图/47µF_63V、低ESR铝电解_插件,D8xL11.5mm.SCHLIB
DSP大板子/器件原理图/100K_0805_Yageo RC0805FR-07100KL.SCHLIB
DSP大板子/器件原理图/100µF_50V，低阻、105℃、直插_EEUFR1H101.SCHLIB
DSP大板子/器件原理图/C0805_Murata GRM21BR71H105KA12L.SCHLIB
DSP大板子/器件原理图/CAN专用TVS.SCHLIB
DSP大板子/器件原理图/DSP扩展板.SCHLIB
DSP大板子/器件原理图/EEPROM.SCHLIB
DSP大板子/器件原理图/MCP2515.SCHLIB
DSP大板子/器件原理图/MOS栅极保护稳压管_BZT52C12-7-F.SCHLIB
DSP大板子/器件原理图/MOS管（2N7002,215）.SCHLIB
DSP大板子/器件原理图/P沟道防反MOS管_DMP6023LE-13.SCHLIB
DSP大板子/器件原理图/TVS（无极性）.SCHLIB
DSP大板子/器件原理图/TVS（有极性）.SCHLIB
DSP大板子/器件原理图/三接口压线端子.SCHLIB
DSP大板子/器件原理图/两接口压线端子.SCHLIB
DSP大板子/器件原理图/保险丝_Littelfuse 0451003.MRL.SCHLIB
DSP大板子/器件原理图/光耦.SCHLIB
DSP大板子/器件原理图/基准电压芯片_REF2030AIDDCR.SCHLIB
DSP大板子/器件原理图/底板开发板_Project.SCHLIB
DSP大板子/器件原理图/放电二极管.SCHLIB
DSP大板子/器件原理图/电容220µF_Panasonic EEU-FR1J221.SCHLIB
DSP大板子/器件原理图/磁珠L0603.SCHLIB
DSP大板子/器件原理图/网口RJ45 Bel SI-46001-F.SCHLIB
DSP大板子/器件原理图/网口芯片KSZ8081RNA.SCHLIB
DSP大板子/器件原理图/调理电路板.SCHLIB
DSP大板子/器件原理图/跳线排针1×2.SCHLIB
DSP大板子/器件原理图/静电和浪涌保护_TPD4E1U06.SCHLIB
